rafalo235/nixie-clock-hw/nixie-module/doc/gn4.pdf

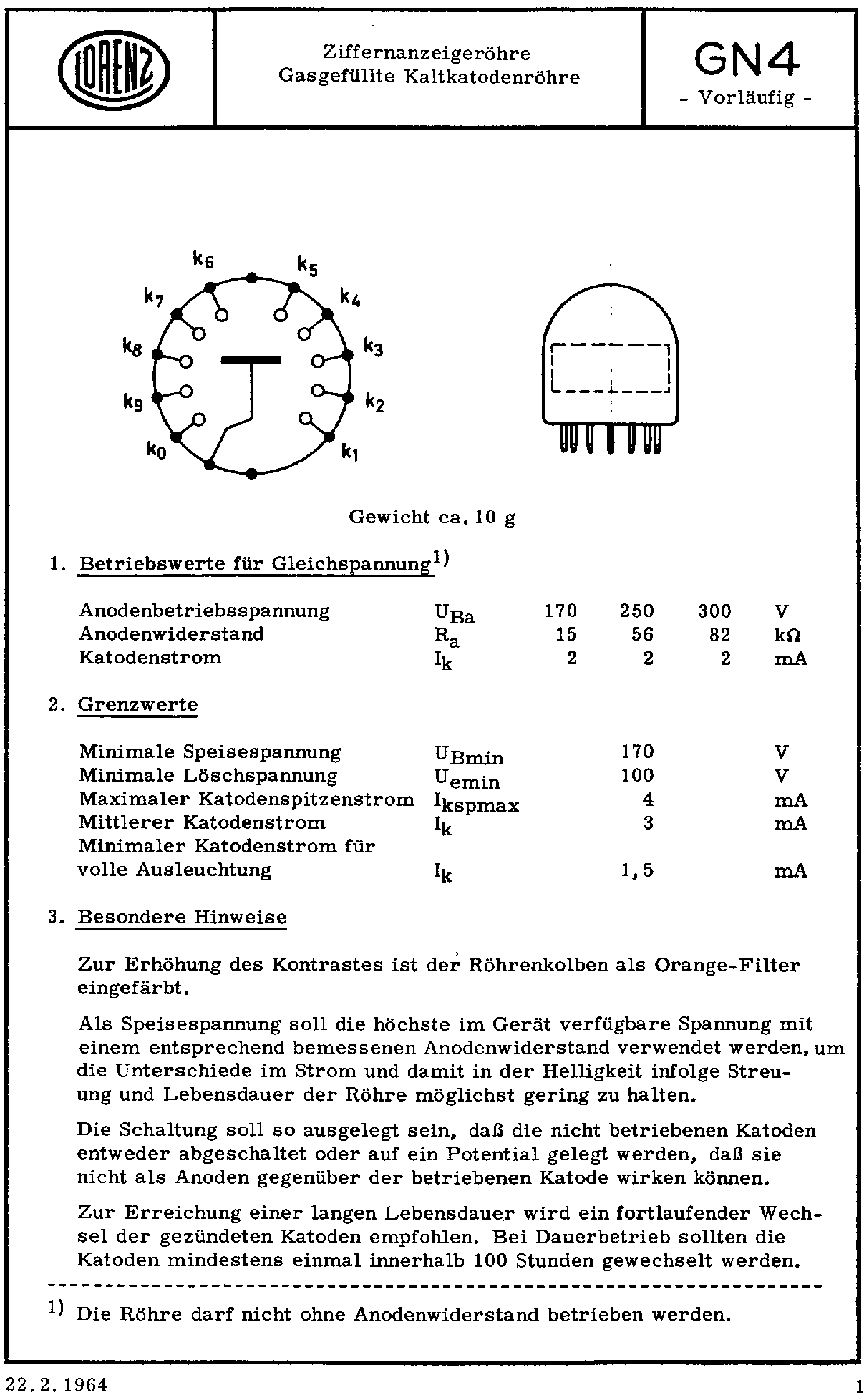
[picture p1: page 1]
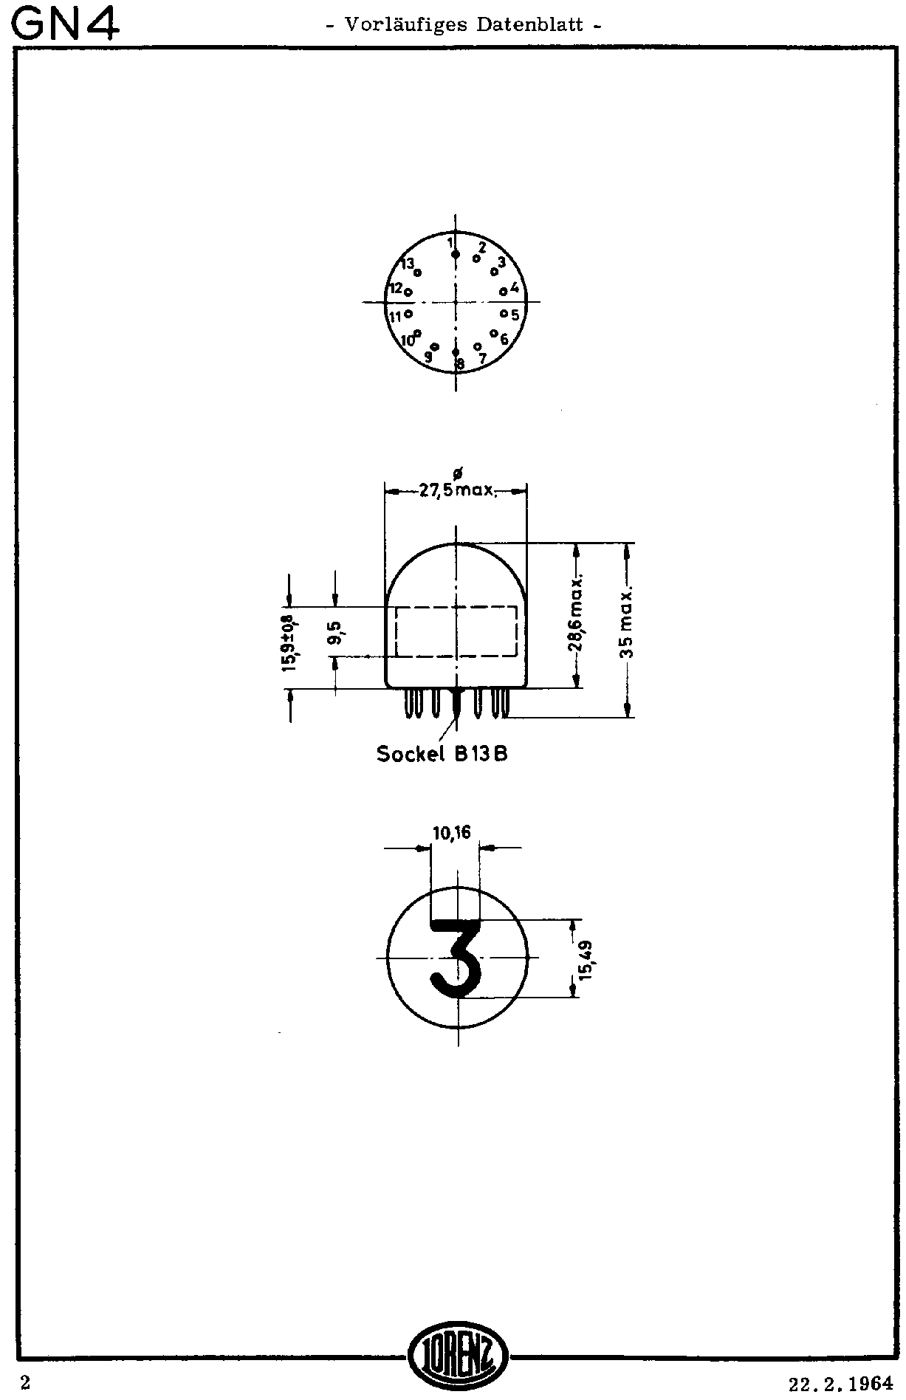
[picture p2: page 2]
