rafalo235/nixie-clock-hw/main-board/doc/DTSN12.pdf

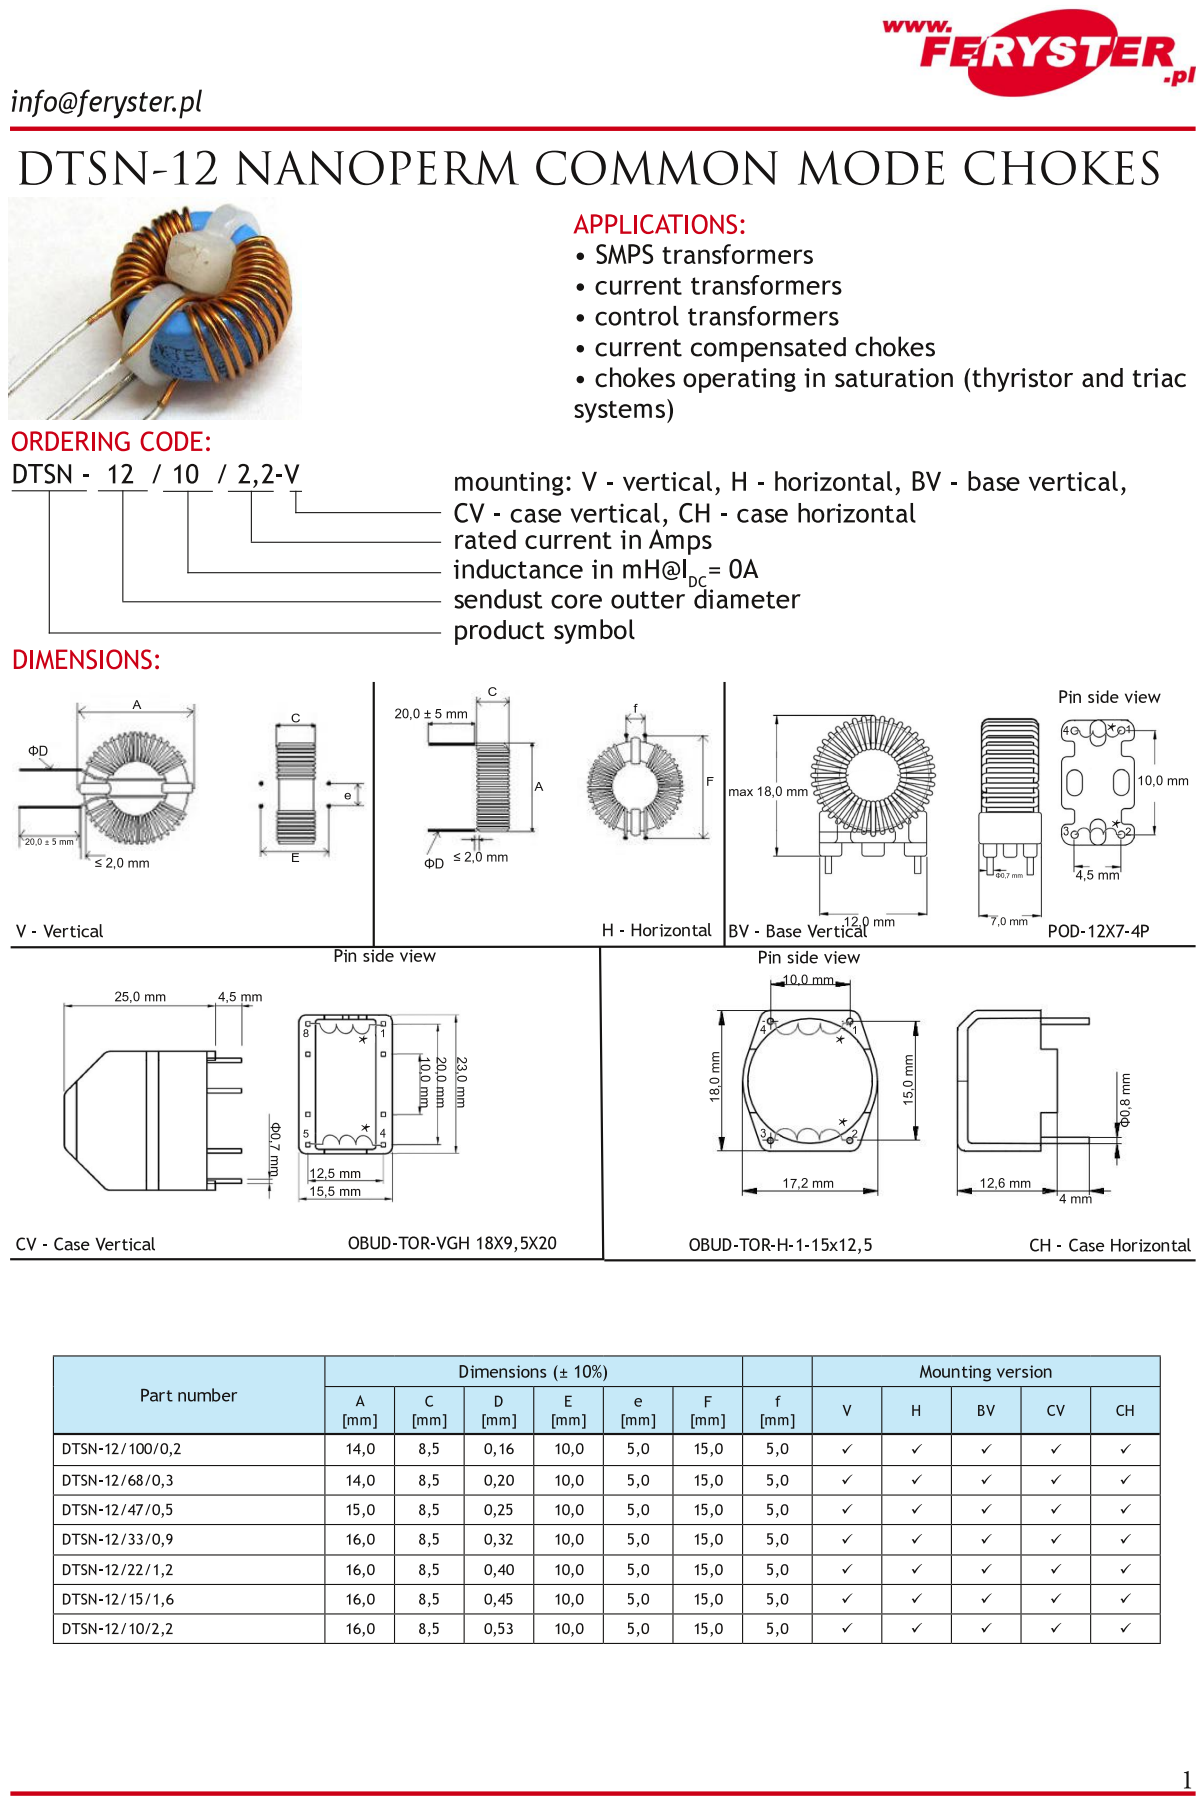
[picture p3: page 1]

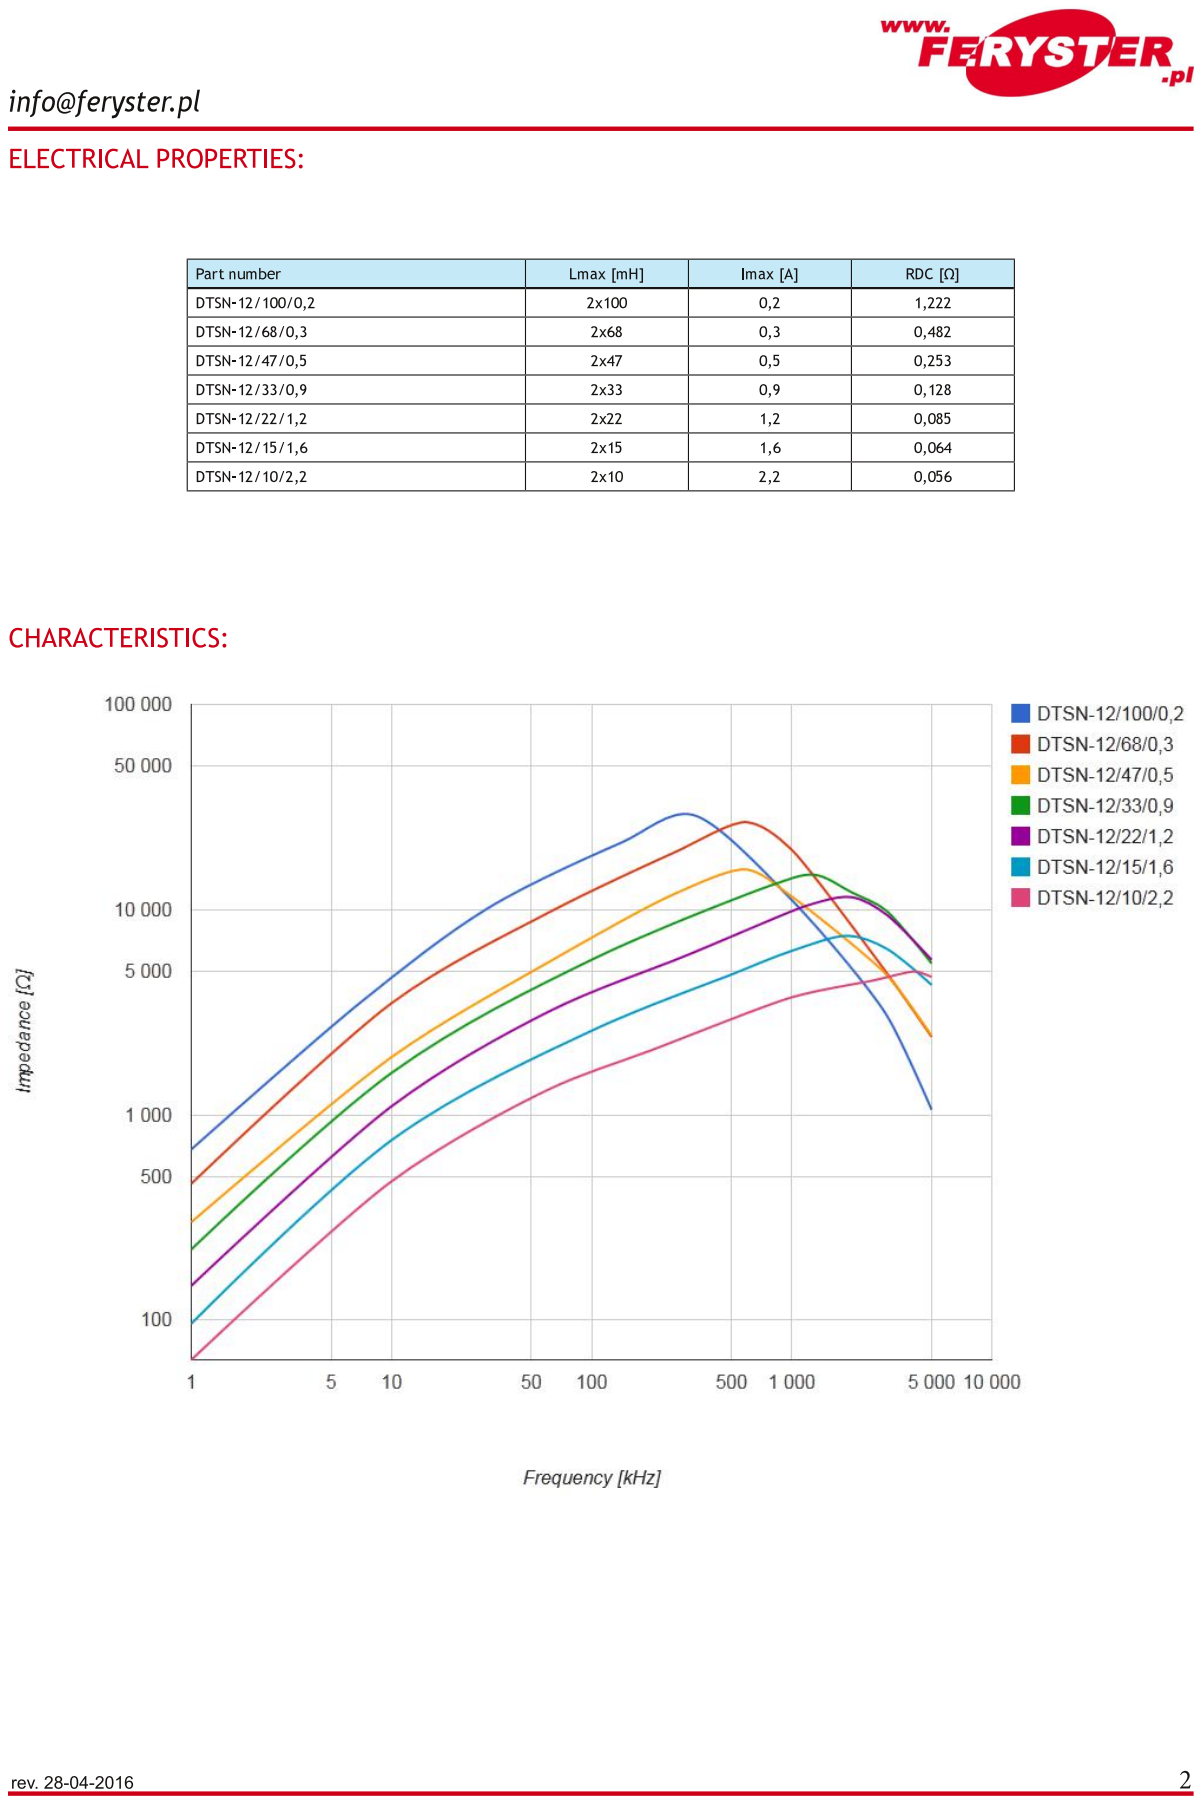
[picture p4: page 2]
