rafalo235/nixie-clock-hw/main-board/nixie-clock.kicad_pcb

## KiCad design main-board/nixie-clock.kicad_pcb (2016-12-22)

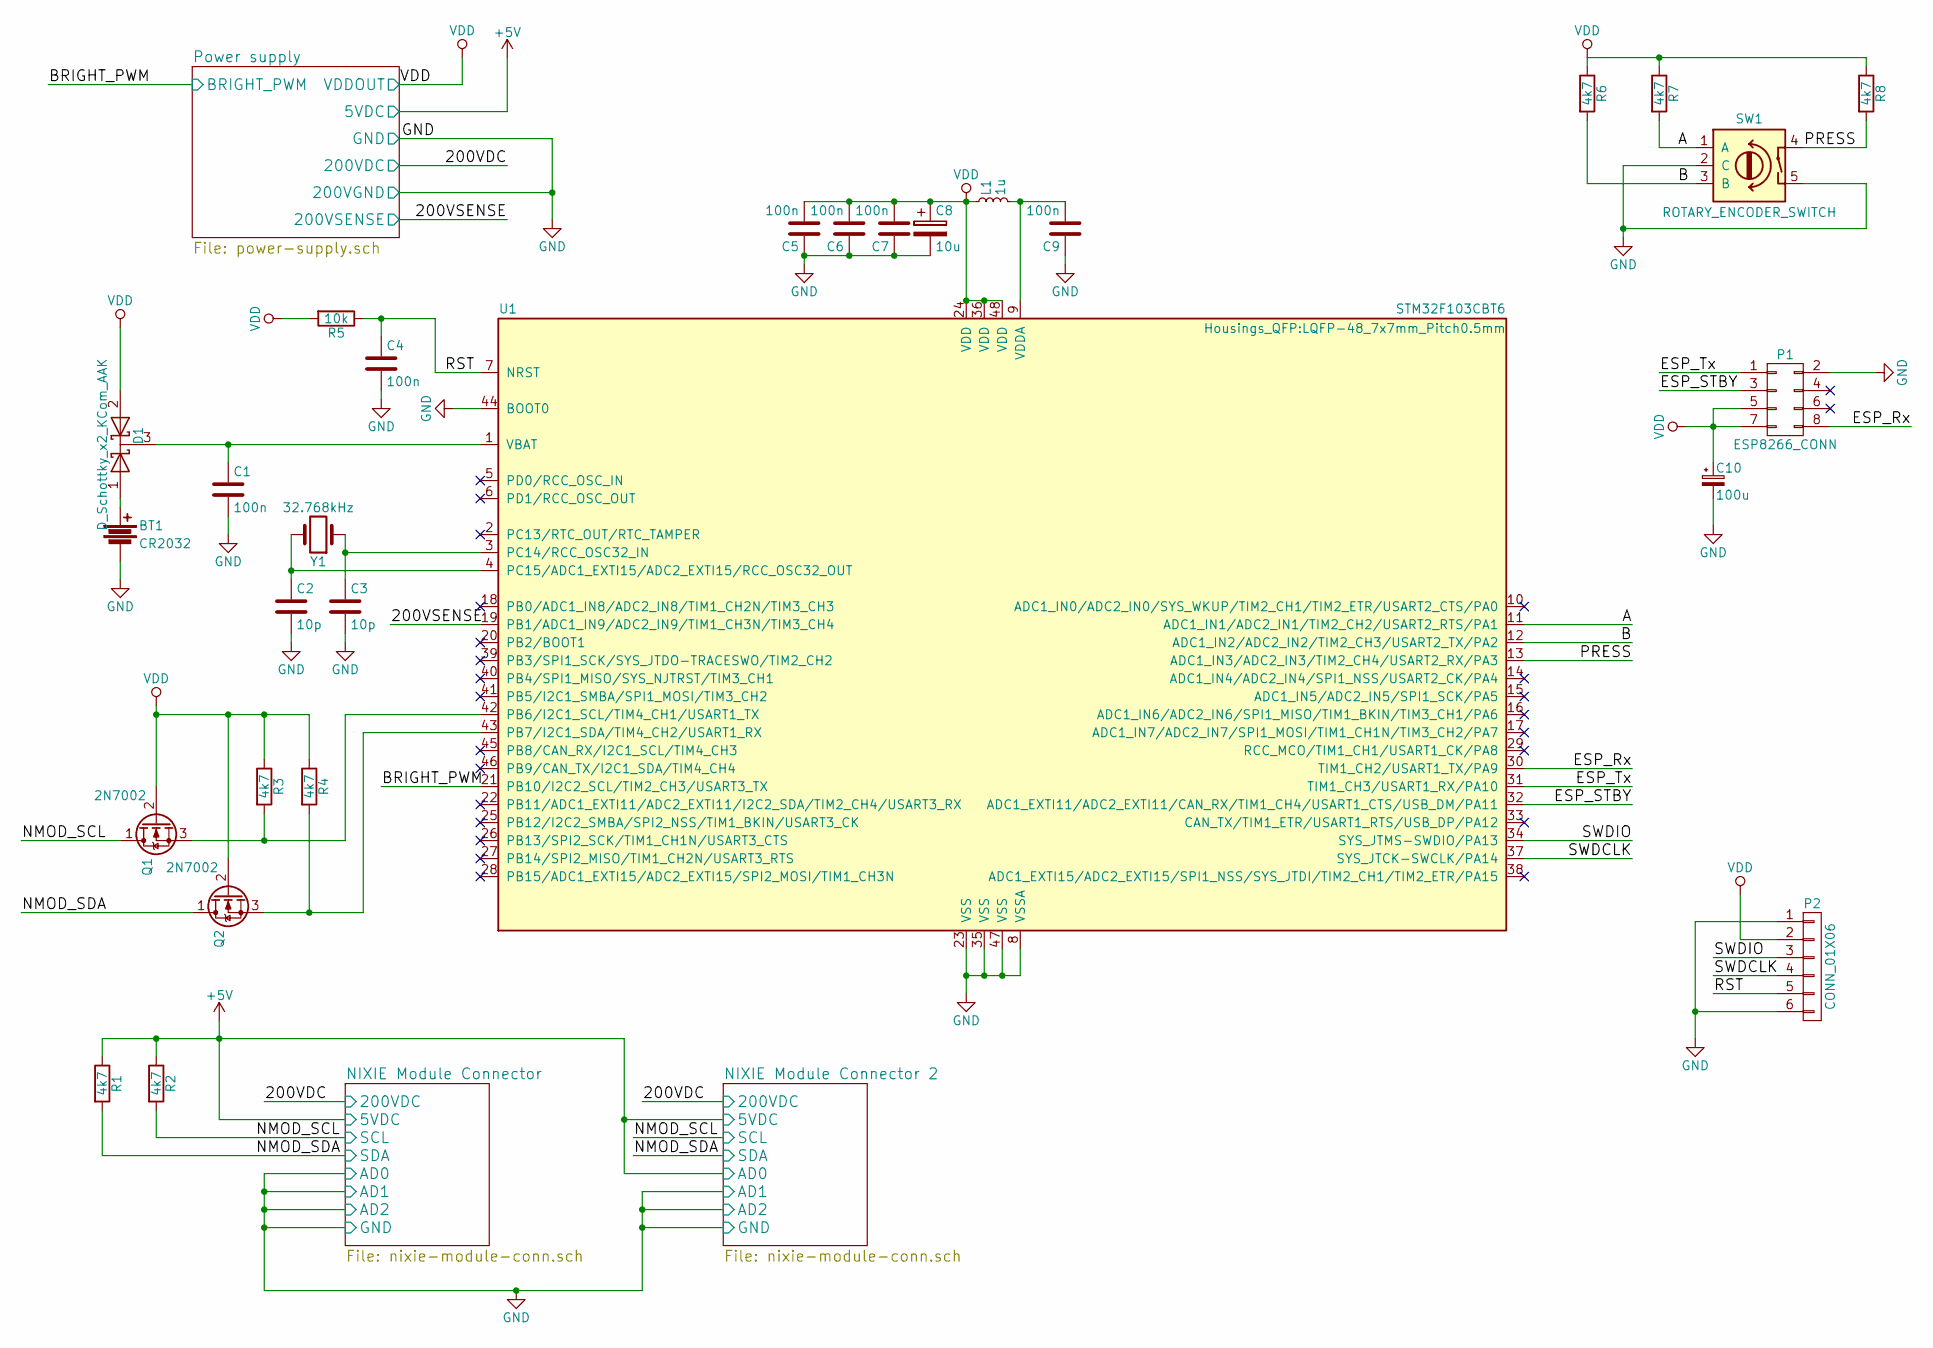
[picture p5: schematic nixie-clock.sch]

Parts:
BT1: CR2032; CR2032H
C1, C4, C5, C6, C7, C9: 100n; C_0805_HandSoldering
C2, C3: 10p; C_0805_HandSoldering
C8: 10u; TantalC_SizeB_EIA-3528_HandSoldering
C10: 100u; TantalC_SizeC_EIA-6032_HandSoldering
D1: D_Schottky_x2_KCom_AAK; SOT-23_Handsoldering
L1: 1u; Choke_SMD_1206_Handsoldering
P1: ESP8266_CONN; Pin_Header_Straight_SMT_02x04
P2: CONN_01X06; Pin_Header_Straight_SMT_02x03
Q1, Q2: 2N7002; SOT-23_Handsoldering
R1, R2, R3, R4, R6, R7, R8: 4k7; R_0805_HandSoldering
R5: 10k; R_0805_HandSoldering
SW1: ROTARY_ENCODER_SWITCH; Pin_Header_Straight_SMT_02x03
U1: STM32F103CBT6; LQFP-48_7x7mm_Pitch0.5mm
Y1: 32.768kHz; Crystal_Round_Vertical_3mm_BigPad; Part no. LFXTAL002996BULK

Connections:
+5V: R1.1, R2.1; also elsewhere on the board
/200VSENSE: U1.19 (PB1/ADC1_IN9/ADC2_IN9/TIM1_CH3N/TIM3_CH4); also elsewhere on the board
/A: R7.2, SW1.1 (A), U1.11 (ADC1_IN1/ADC2_IN1/TIM2_CH2/USART2_RTS/P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)
/B: R6.2, SW1.3 (B), U1.12 (ADC1_IN2/ADC2_IN2/TIM2_CH3/USART2_TX/PA2)
/BRIGHT_PWM: U1.21 (PB10/I2C2_SCL/TIM2_CH3/USART3_TX); also elsewhere on the board
/ESP_Rx: P1.8, U1.30 (TIM1_CH2/USART1_TX/PA9)
/ESP_STBY: P1.3, U1.32 (ADC1_EXTI11/ADC2_EXTI11/CAN_RX/TIM1_CH4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)
/ESP_Tx: P1.1, U1.31 (TIM1_CH3/USART1_RX/PA10)
/NMOD_SCL: Q1.1 (D), R2.2; also elsewhere on the board
/NMOD_SDA: Q2.1 (D), R1.2; also elsewhere on the board
/PRESS: R8.2, SW1.4, U1.13 (ADC1_IN3/ADC2_IN3/TIM2_CH4/USART2_RX/PA3)
/RST: C4.1, P2.5, R5.1, U1.7 (NRST)
/SWDCLK: P2.4, U1.37 (SYS_JTCK-SWCLK/PA14)
/SWDIO: P2.3, U1.34 (SYS_JTMS-SWDIO/PA13)
GND: BT1.2, C1.2, C2.2, C3.2, C4.2, C5.1, C6.1, C7.1, C8.2, C9.1, C10.2, P1.2, P2.1, P2.6, SW1.2 (C), SW1.5, U1.8 (VSSA), U1.23 (VSS), U1.35 (VSS), U1.44 (BOOT0), U1.47 (VSS); also elsewhere on the board
unnamed: BT1.1, D1.1 (A)
unnamed: C1.1, D1.3 (K), U1.1 (VBAT)
unnamed: C2.1, U1.4 (PC15/ADC1_EXTI15/ADC2_EXTI15/RCC_OSC32_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), Y1.2
unnamed: C3.1, U1.3 (PC14/RCC_OSC32_IN), Y1.1
unnamed: C9.2, L1.2, U1.9 (VDDA)
unnamed: Q1.3 (S), R3.2, U1.42 (PB6/I2C1_SCL/TIM4_CH1/USART1_TX)
unnamed: Q2.3 (S), R4.2, U1.43 (PB7/I2C1_SDA/TIM4_CH2/USART1_RX)
VDD: C5.2, C6.2, C7.2, C8.1, C10.1, D1.2 (A), L1.1, P1.5, P1.7, P2.2, Q1.2 (G), Q2.2 (G), R3.1, R4.1, R5.2, R6.1, R7.1, R8.1, U1.24 (VDD), U1.36 (VDD), U1.48 (VDD); also elsewhere on the board

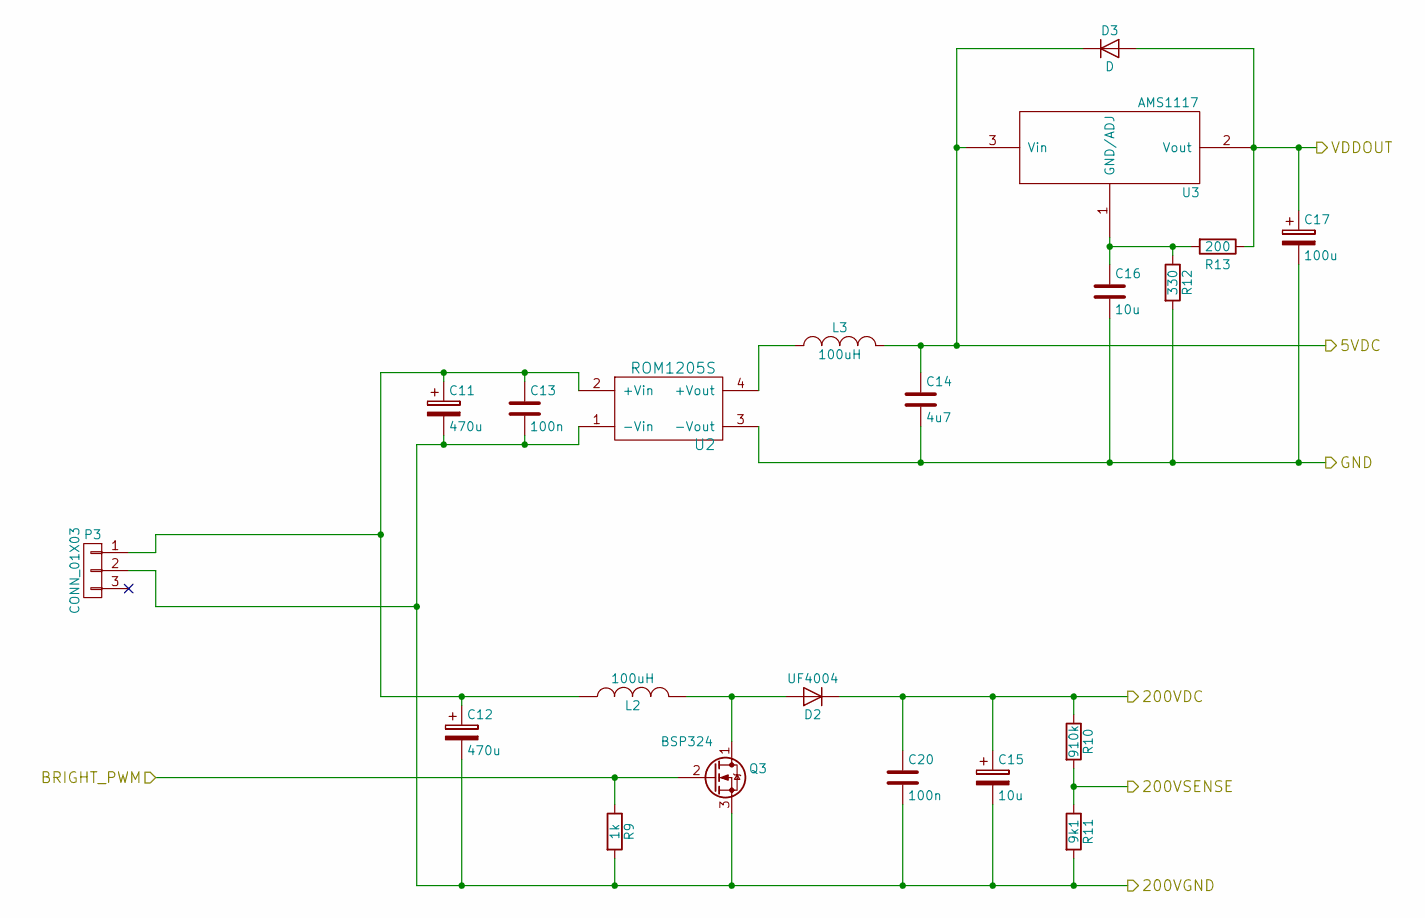
[picture p6: schematic power-supply.sch, Nixie clock power supply]

Parts:
C11, C12: 470u; c_elec_10x10
C13: 100n; C_0805_HandSoldering
C14: 4u7; C_0805_HandSoldering
C15: 10u; C_Radial_D10_L20_P5; Part no. TVX2F100MCD
C16: 10u; TantalC_SizeB_EIA-3528_HandSoldering
C17: 100u; TantalC_SizeC_EIA-6032_HandSoldering
C20: 100n; C_1812_HandSoldering
D2: UF4004; Diode_DO-41_SOD81_Vertical_AnodeUp
D3: D; MiniMELF_Handsoldering
L2: 100uH; Neosid_Inductor_Sd8; Part no. 5900-103-RC
L3: 100uH; R_1812_HandSoldering
P3: CONN_01X03; BARREL_JACK
Q3: BSP324; SOT-223; Part no. BSP324H6327XTSA1
R9: 1k; R_0805_HandSoldering
R10: 910k; R_1206_HandSoldering
R11: 9k1; R_1206_HandSoldering
R12: 330; R_0805_HandSoldering
R13: 200; R_0805_HandSoldering
U2: ROM1205S; SIP4
U3: AMS1117; TO-252-2Lead

Connections:
+5V: C14.1, D3.1 (K), L3.2, U3.3 (Vin); also elsewhere on the board
/200VDC: C15.1, C20.1, D2.1 (K), R10.1; also elsewhere on the board
/200VSENSE: R10.2, R11.1; also elsewhere on the board
/BRIGHT_PWM: Q3.2 (G), R9.1; also elsewhere on the board
GND: C11.2, C12.2, C13.2, C14.2, C15.2, C16.2, C17.2, C20.2, P3.2, Q3.3 (S), R9.2, R11.2, R12.2, U2.1 (-Vin), U2.3 (-Vout); also elsewhere on the board
unnamed: C11.1, C12.1, C13.1, L2.1, P3.1, U2.2 (+Vin)
unnamed: C16.1, R12.1, R13.2, U3.1 (GND/ADJ)
unnamed: D2.2 (A), L2.2, Q3.1 (D)
unnamed: L3.1, U2.4 (+Vout)
VDD: C17.1, D3.2 (A), R13.1, U3.2 (Vout); also elsewhere on the board

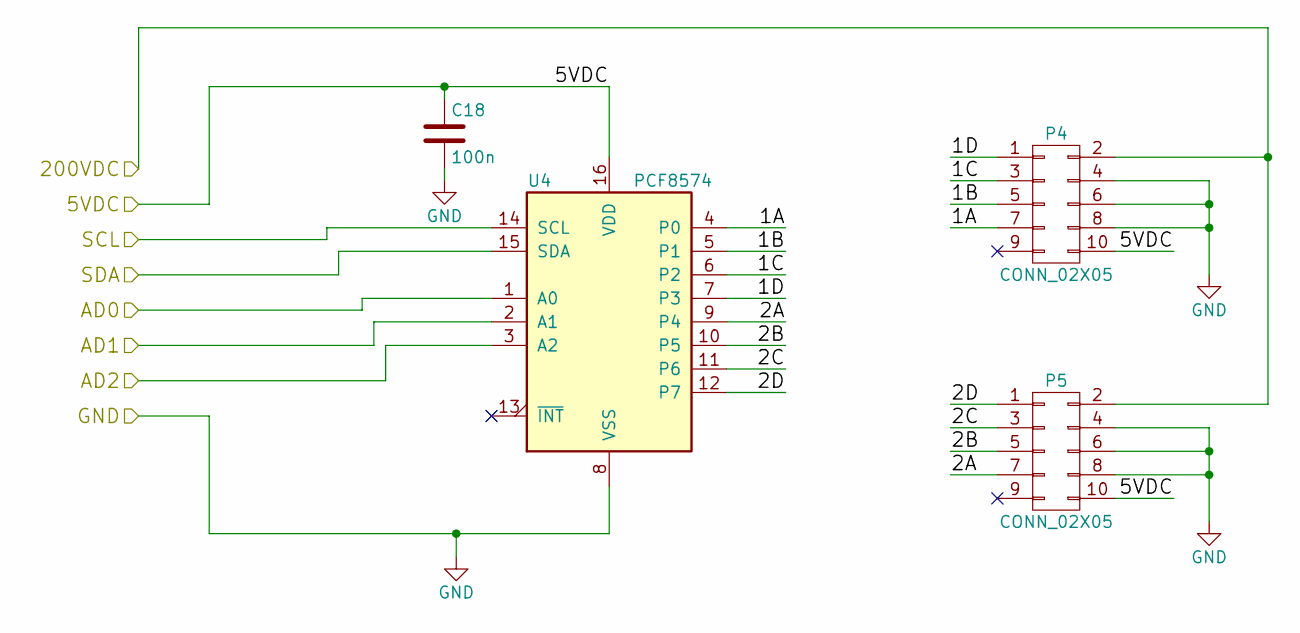
[picture p7: schematic nixie-module-conn.sch]

Parts:
C18: 100n; C_0805_HandSoldering
P4, P5: CONN_02X05; Pin_Header_Straight_SMT_02x05
U4: PCF8574; SOIC-16W_7.5x10.3mm_Pitch1.27mm

Connections:
+5V: C18.1, P4.10, P5.10, U4.16 (VDD); also elsewhere on the board
/200VDC: P4.2, P5.2; also elsewhere on the board
/NIXIE Module Connector/1A: P4.7, U4.4 (P0)
/NIXIE Module Connector/1B: P4.5, U4.5 (P1)
/NIXIE Module Connector/1C: P4.3, U4.6 (P2)
/NIXIE Module Connector/1D: P4.1, U4.7 (P3)
/NIXIE Module Connector/2A: P5.7, U4.9 (P4)
/NIXIE Module Connector/2B: P5.5, U4.10 (P5)
/NIXIE Module Connector/2C: P5.3, U4.11 (P6)
/NIXIE Module Connector/2D: P5.1, U4.12 (P7)
/NMOD_SCL: U4.14 (SCL); also elsewhere on the board
/NMOD_SDA: U4.15 (SDA); also elsewhere on the board
GND: C18.2, P4.4, P4.6, P4.8, P5.4, P5.6, P5.8, U4.1 (A0), U4.2 (A1), U4.3 (A2), U4.8 (VSS); also elsewhere on the board

Parts of its further copies:
C19: 100n; C_0805_HandSoldering
P6, P7: CONN_02X05; Pin_Header_Straight_SMT_02x05
U5: PCF8574; SOIC-16W_7.5x10.3mm_Pitch1.27mm

Connections of its further copies:
+5V: C19.1, P6.10, P7.10, U5.1 (A0), U5.16 (VDD); also elsewhere on the board
/200VDC: P6.2, P7.2; also elsewhere on the board
/NIXIE Module Connector 2/1A: P6.7, U5.4 (P0)
/NIXIE Module Connector 2/1B: P6.5, U5.5 (P1)
/NIXIE Module Connector 2/1C: P6.3, U5.6 (P2)
/NIXIE Module Connector 2/1D: P6.1, U5.7 (P3)
/NIXIE Module Connector 2/2A: P7.7, U5.9 (P4)
/NIXIE Module Connector 2/2B: P7.5, U5.10 (P5)
/NIXIE Module Connector 2/2C: P7.3, U5.11 (P6)
/NIXIE Module Connector 2/2D: P7.1, U5.12 (P7)
/NMOD_SCL: U5.14 (SCL); also elsewhere on the board
/NMOD_SDA: U5.15 (SDA); also elsewhere on the board
GND: C19.2, P6.4, P6.6, P6.8, P7.4, P7.6, P7.8, U5.2 (A1), U5.3 (A2), U5.8 (VSS); also elsewhere on the board

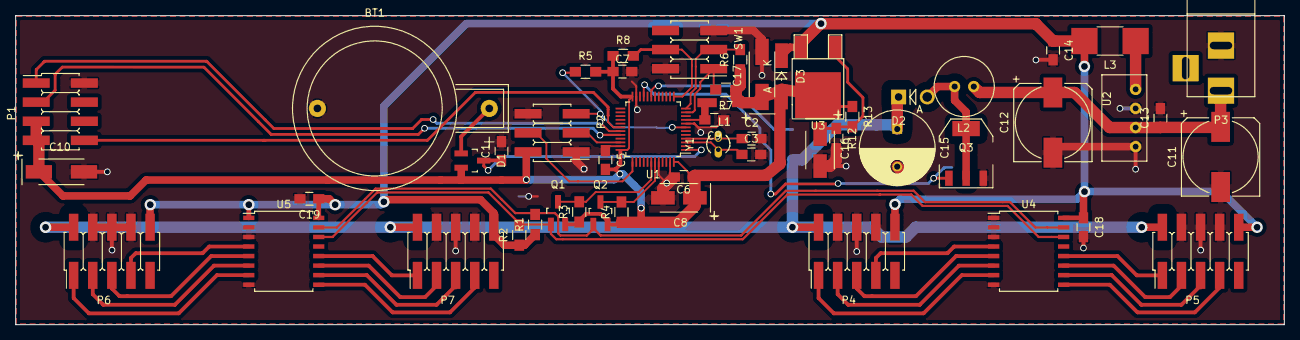
[picture p8: board nixie-clock.kicad_pcb from above]

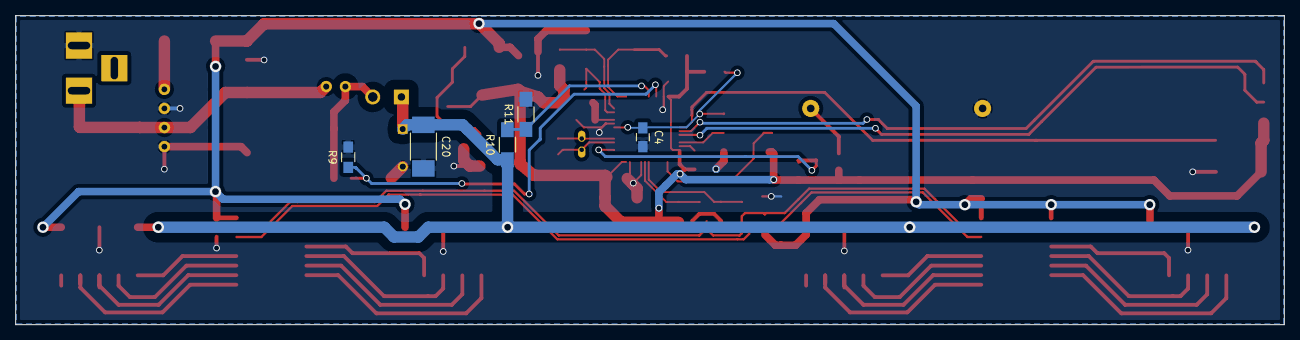
[picture p9: board nixie-clock.kicad_pcb from below]

Board: 2 copper layers, 168.7 x 41.1 mm, 57 parts (5 on the bottom side), 44 nets.
