rafalo235/nixie-clock-hw/nixie-module/nixie-module.kicad_pcb

## KiCad design nixie-module/nixie-module.kicad_pcb (2016-12-22)

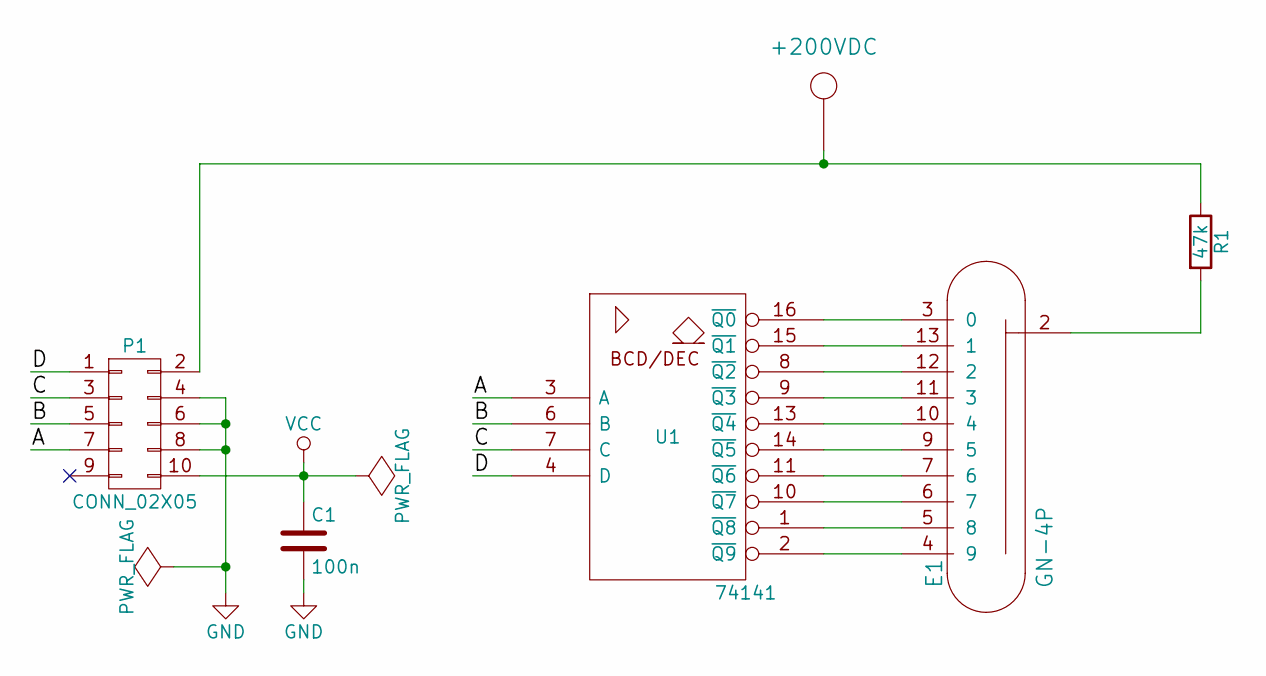
[picture p10: schematic nixie-module.sch]

Parts:
C1: 100n; C_0805_HandSoldering
E1: GN-4P; gn-4p-gniazdo
P1: CONN_02X05; Pin_Header_Angled_2x05
R1: 47k; R_1812_HandSoldering
U1: 74141; DIP-16_W7.62mm_LongPads

Connections:
/A: P1.7, U1.3 (A)
/B: P1.5, U1.6 (B)
/C: P1.3, U1.7 (C)
/D: P1.1, U1.4 (D)
GND: C1.2, P1.4, P1.6, P1.8, U1.12 (GND)
unnamed: E1.2, R1.2
unnamed: E1.3 (0), U1.16 (~Q0)
unnamed: E1.4 (9), U1.2 (~Q9)
unnamed: E1.5 (8), U1.1 (~Q8)
unnamed: E1.6 (7), U1.10 (~Q7)
unnamed: E1.7 (6), U1.11 (~Q6)
unnamed: E1.9 (5), U1.14 (~Q5)
unnamed: E1.10 (4), U1.13 (~Q4)
unnamed: E1.11 (3), U1.9 (~Q3)
unnamed: E1.12 (2), U1.8 (~Q2)
unnamed: E1.13 (1), U1.15 (~Q1)
unnamed: P1.2, R1.1
VCC: C1.1, P1.10, U1.5 (VCC)

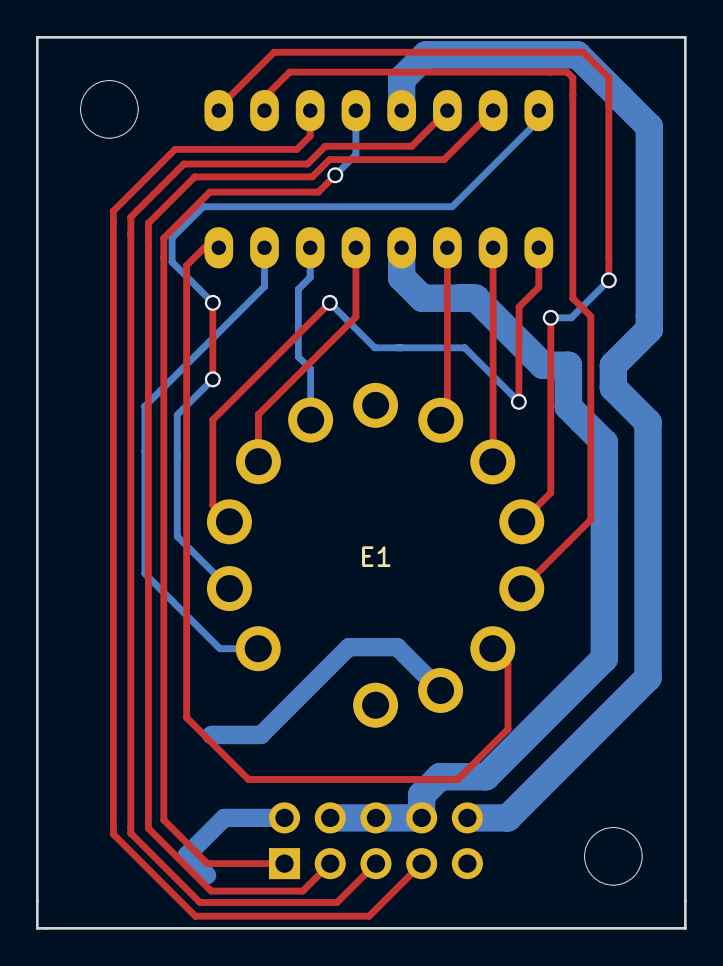
[picture p11: board nixie-module.kicad_pcb from above]

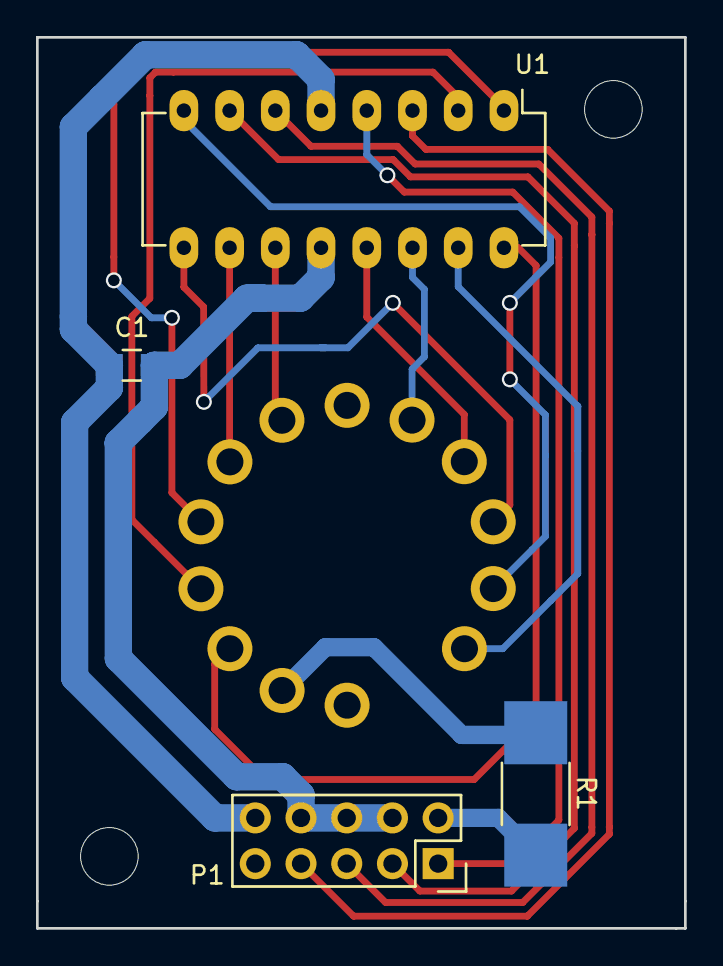
[picture p12: board nixie-module.kicad_pcb from below]

Board: 2 copper layers, 36.0 x 49.5 mm, 5 parts (3 on the bottom side), 18 nets.
