rafalo235/nixie-clock-hw/(commit log)

2016-10-21 Pliki projektu
    [nixie-clock.kicad_pcb, nixie-clock.sch]
2016-10-21 Wybor procesora
    [nixie-clock.sch]
2016-10-21 Dodanie oscylatorow 8MHz i 32kHz
    [nixie-clock.sch]
2016-10-21 Usuniecie oscylatora 8MHz; zasilanie bateryjne
    [nixie-clock.sch]
2016-10-29 Zasilanie ukladu - rozpoczete
    [nixie-clock.sch, power-supply.sch]
2016-10-31 Wyprowadzenie VDD (3,3V); komentarze
    [nixie-clock.sch, power-supply.sch]
2016-10-31 Wyprowadzenia do modulu ESP8266
    [nixie-clock.sch]
2016-10-31 Kontrola jasnosci NIXIE
    [nixie-clock.sch, power-supply.sch]
2016-11-01 Rozdzielenie projektu
    [nixie-clock.kicad_pcb, nixie-clock.sch, power-supply.sch]
2016-11-01 Modul lampy NIXIE
    [nixie-module.kicad_pcb, nixie-module.sch]
2016-11-01 GPIO Expander - podlaczenie do STM32; wyprowadzenia dla modulow NIXIE; zasilanie - do poprawki (GPIO Expander zasilany z 5V - STM 3,3V
    [nixie-clock.sch, nixie-module-conn.sch, power-supply.sch]
2016-11-07 Dokumentacja STM32F103CBT6; poprawki zasilania, podciagniecie linii SDA i SCL, kondensator przy ESP8266 #1
    [nixie-clock.sch]
2016-11-08 Poprawka zasilania stm32 i esp; VSS-GND
    [nixie-clock.sch]
2016-11-11 #1 - enkoder zamiast potencjometru; pomiar napiecia zarzenia; SWD; BOOT0 do masy
    [nixie-clock.sch, nixie-module-conn.sch, power-supply.sch]
2016-11-11 #1 - zmiana wartosci kondensator do typuszeregu, usuniecie D2, UF4004 na D4, przyciagniecie do masy bramki Q1, bezpiecznik na wejsciu przetwornicy, gniazdo IEC C7, 100n na zasilaniu PCF8574
    [nixie-module-conn.sch, power-supply.sch]
2016-11-11 #1 - Przetwornica DC/DC 12V/5V
    [power-supply.sch]
2016-11-11 #1 - dokumentacja ROM-1205S; usuniecie komentarza
    [power-supply.sch]
2016-11-12 #1 - stabilizator LDO AMS1117-3.3V
    [nixie-clock.sch, nixie-module-conn.sch, power-supply.sch]
2016-11-12 Niezapisane zmiany
    [power-supply.sch]
2016-11-12 Polaczenie masy wyjscia ROM-1205S z masa 200V (-Vin z -Vout)
    [nixie-clock.sch]
2016-11-18 #1 - Poprawienie otoczenia ukladow od zasilania; tolerancja 1% rezystorow dzielnika pomiarowego; usuniecie kondensatora filtrujacego wyjscie z enkodera; oddalenie od siebie linii (przeniesienie 200VS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
    [nixie-clock.sch, power-supply.sch]
2016-11-21 Kondensator przy zasilaniu ukladu 74141
    [nixie-module.sch]
2016-11-21 Zewnetrzny zasilacz 12V
    [power-supply.sch]
2016-11-25 Oznaczenie MOSFET-ow od I2C; pojemnosc do filtrowania wysokich czestotliwosci za przetwornica boost; obudowy wiekszosci elementow
    [nixie-clock.sch, nixie-module-conn.sch, power-supply.sch]
2016-11-25 Dobranie parametrow przetwornicy boost + obudowy; obudowa do dlawika z ROM1205S
    [power-supply.sch]
2016-11-26 Obudowa SIP4 do ukladu ROM1205S; utworzenie lokalnej biblioteki footprintow
    [power-supply.sch]
2016-11-28 Rozpoczecie projektu PCB
2016-11-30 Poprawione polaczenie sciezek; zmiana nazwy wyjscia VDD
    [nixie-clock.kicad_pcb, nixie-clock.sch, power-supply.sch]
2016-12-01 usunięcie błędnego połączenia VDD z +5V
    [nixie-clock.kicad_pcb, nixie-clock.sch, nixie-module-conn.sch, power-supply.sch]
2016-12-14 Obrys plytki 40% elementow
    [nixie-clock.kicad_pcb, nixie-module-conn.sch, power-supply.sch]
2016-12-15 Do zrobienia przelotki; elementy rozmieszczone
    [nixie-clock.kicad_pcb]
2016-12-15 Do sprawdzenia
    [nixie-clock.kicad_pcb]
2016-12-15 Poprawka - dioda pod napieciem z wiekszym odstepem
    [nixie-clock.kicad_pcb]
2016-12-15 Przypisanie elementow (poza lampa) do obudow
    [nixie-module.sch]
2016-12-15 Poprawienie pinow w gniezdzie
    [nixie-module.sch]
2016-12-15 Lokalna biblioteka footprint - nixie module; tymczasowe gniazdo do lampy
    [nixie-module.sch]
2016-12-16 Gotowe gniazdo na GN4P - wlutowanie nitow 1mm
    [nixie-module.sch]
2016-12-16 Reguly DRC; wymiary plytki
    [nixie-module.kicad_pcb]
2016-12-16 Odwrocenie numeracji pinow w zlaczu od modulu NIXIE
    [nixie-module.kicad_pcb, nixie-module.sch]
2016-12-16 Poprawienie rozmiarow modulu NIXIE - lampa kolidowalaby z lutami od 74141 i listwy
    [nixie-module.kicad_pcb]
2016-12-20 Modyfikacja sciezek modulu NIXIE
    [nixie-module.kicad_pcb]
2016-12-20 Przesuniecie etykiet na module NIXIE
    [nixie-module.kicad_pcb]
2016-12-20 Poprawki; otwory montazowe; obrys
    [nixie-module.kicad_pcb]
2016-12-20 Generowanie gerberow
    [nixie-module.kicad_pcb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]
2016-12-20 Poprawiona plytka
    [nixie-module.kicad_pcb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]
2016-12-22 poprawki prowadzenia ścieżek, footprintów, zmniejszenie rozmiaru płytki pod lampę nixie
    [nixie-clock.kicad_pcb, nixie-clock.sch, nixie-module-conn.sch, nixie-module.kicad_pcb, power-supply.sch]
2016-12-22 poprawka oznaczenia lampy na płytce, wygenerowanie plików produkcyjnych do nixie-module
    [nixie-module.kicad_pcb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]
2016-12-22 wygenerowanie plików produkcyjnych do płytki main-board
    [nixie-clock-B.Cu.gbl, nixie-clock-B.Mask.gbs, nixie-clock-B.SilkS.gbo, nixie-clock-Edge.Cuts.gm1, nixie-clock-F.Cu.gtl, nixie-clock-F.Mask.gts, nixie-clock-F.SilkS.gto, nixie-clock.drl]
